sergiosiniy/soldering_station/t12_iron_sheme/87-8_P-mosfet.jpg

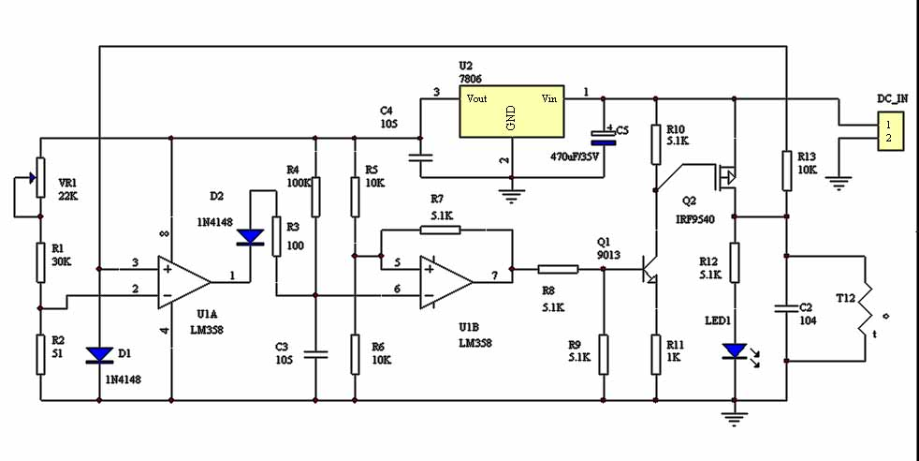
t12_iron_sheme/87-8_P-mosfet.jpg
