sergiosiniy/soldering_station/t12_iron_sheme/87-10_N-mosfet.jpg

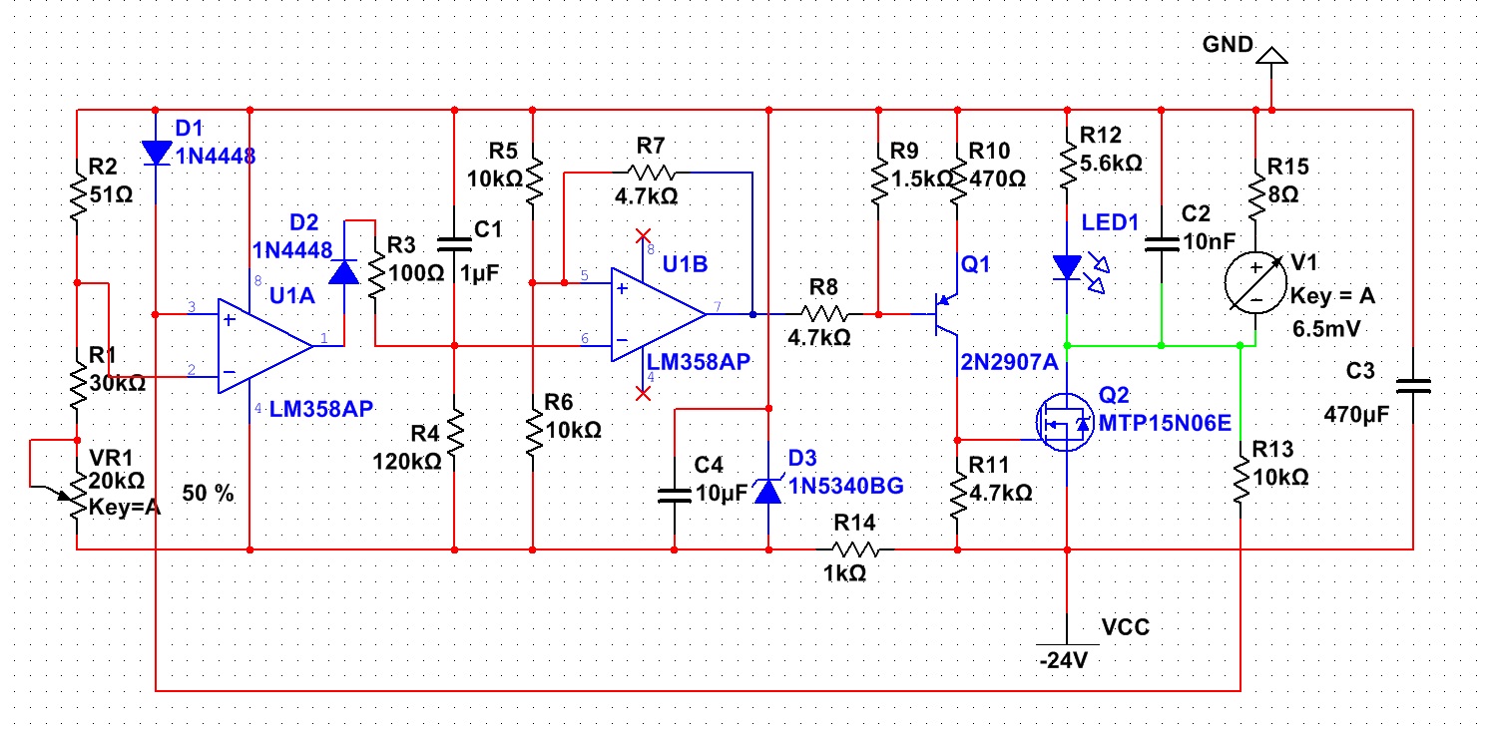
t12_iron_sheme/87-10_N-mosfet.jpg
