sergiosiniy/soldering_station/t12_iron_sheme/95-22.jpg

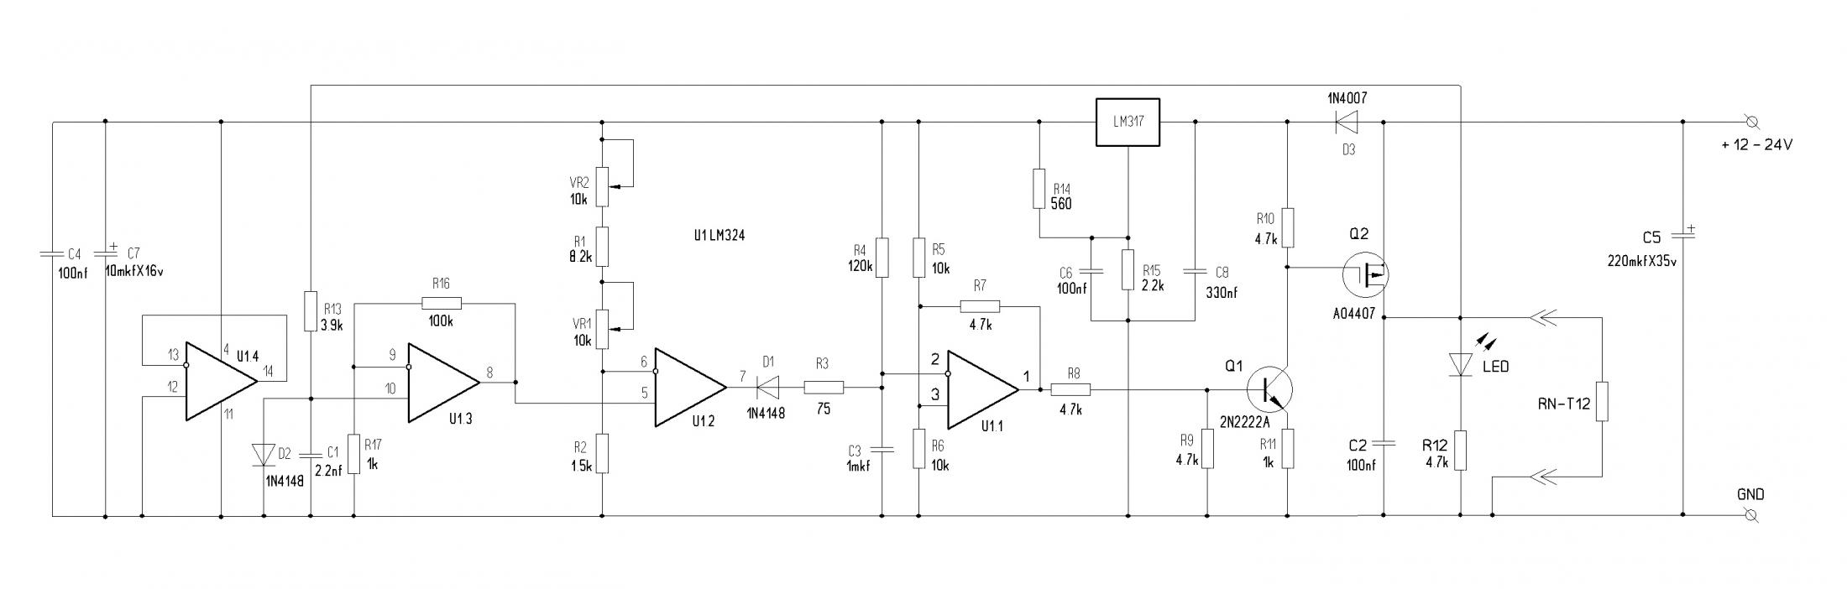
t12_iron_sheme/95-22.jpg
