sergiosiniy/soldering_station/t12_iron_sheme/44668_T12 Lm393 NMosfet.png

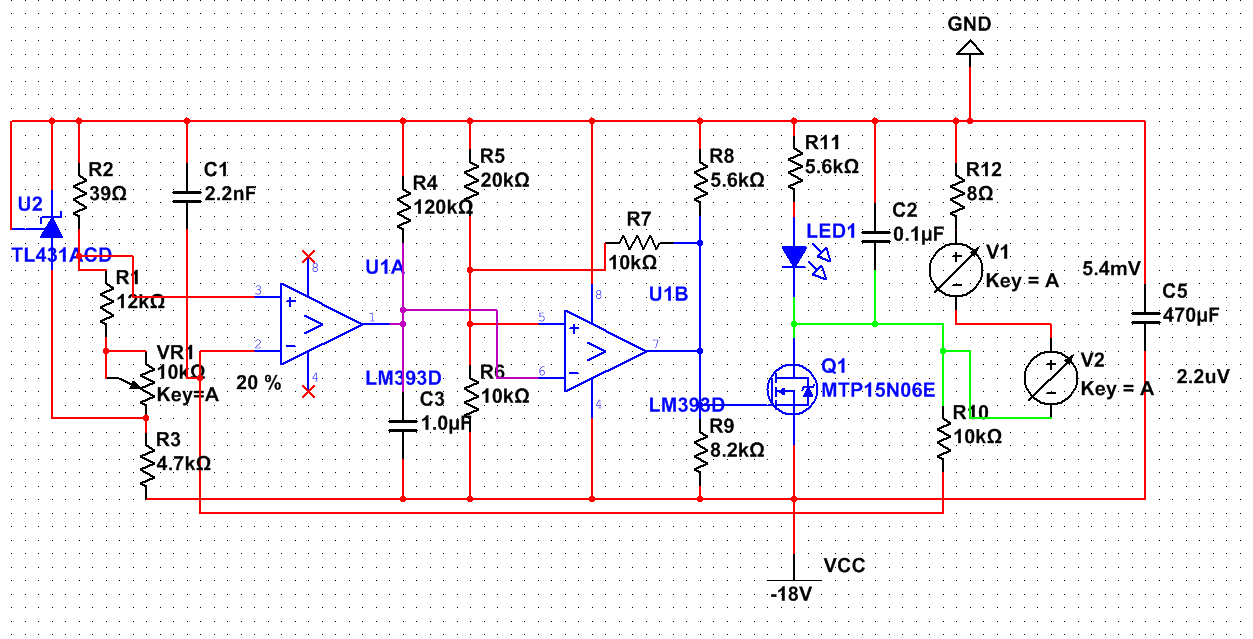
t12_iron_sheme/44668_T12 Lm393 NMosfet.png
