sergiosiniy/soldering_station/v7/a2900_schematic.gif

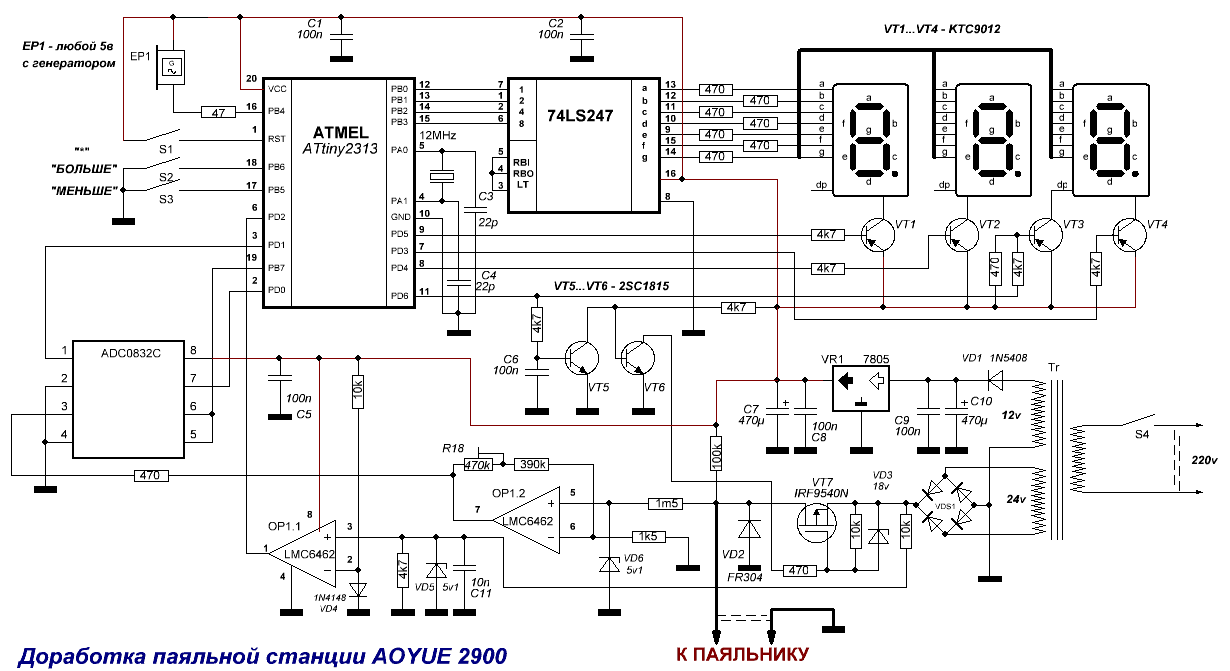
v7/a2900_schematic.gif
