sergiosiniy/soldering_station/особенность_БП_конденсатор.pdf

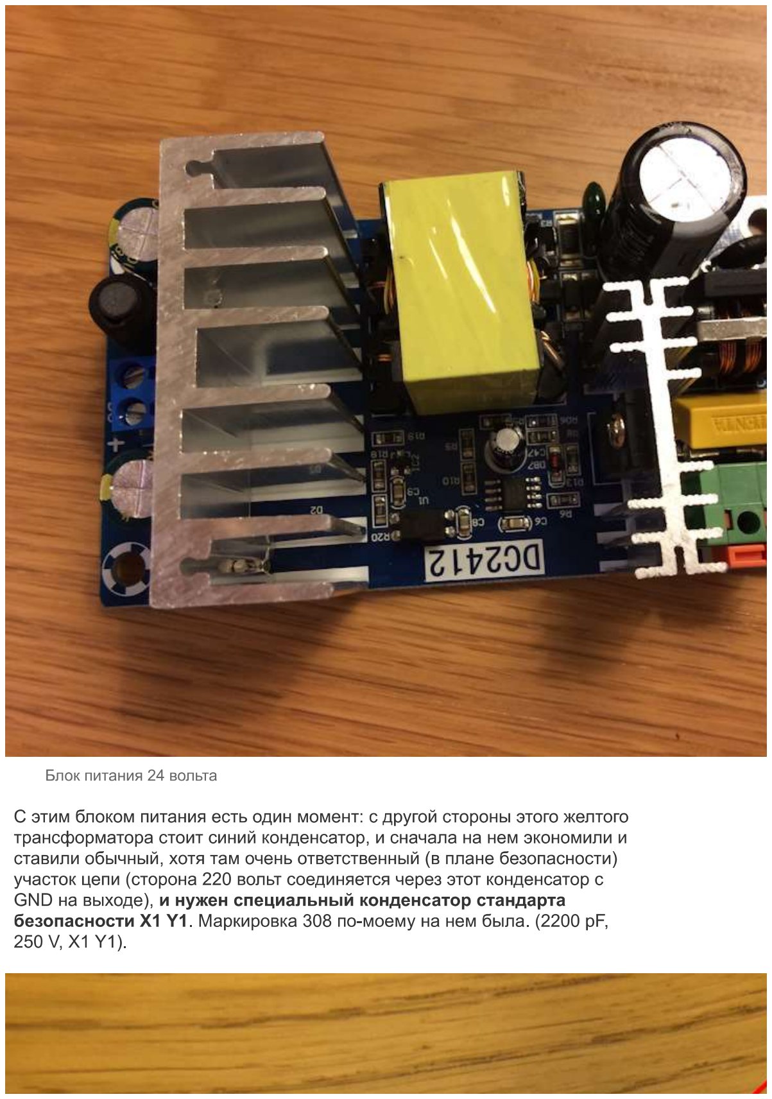
[picture p7: page 1]

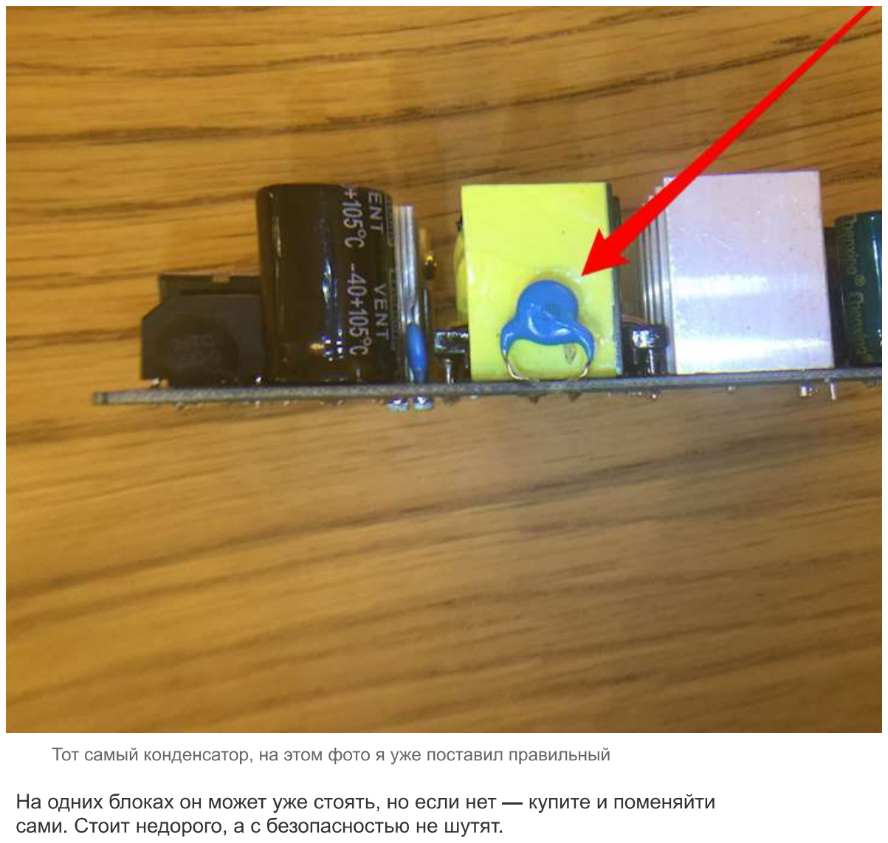
[picture p8: page 2]
