sergiosiniy/soldering_station/(list of files, drawings)

Other design files:
t12_iron_sheme/01.lay
t12_iron_sheme/87_t12.lay
v1/SolderStation.lay6
