sergiosiniy/soldering_station/(commit log)

2018-11-26 t12 iron connection schemes
    [87_t12.lay]
2018-11-26 one more scheme connection t12 iron
    [01.lay]
2018-11-29 soldering v7
